obfuscated/thekbd/datasheets/pololu_astar32u4_mini_ulv_pinout.jpg

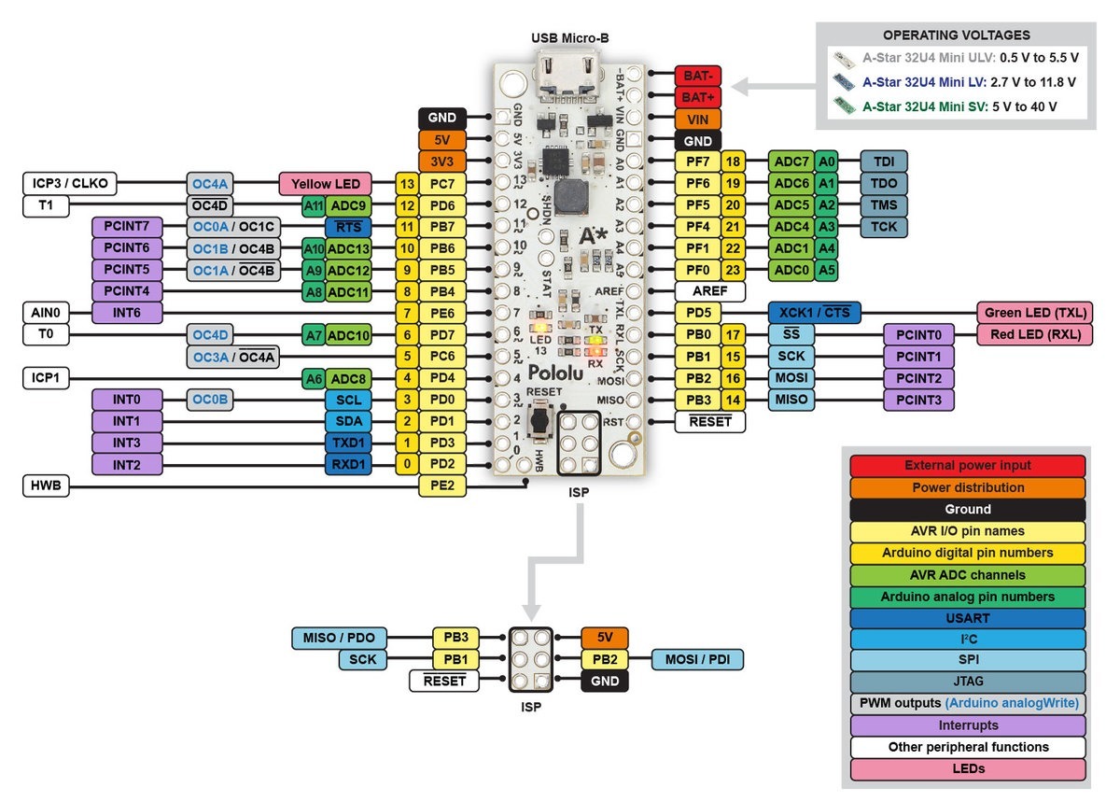
datasheets/pololu_astar32u4_mini_ulv_pinout.jpg
