obfuscated/thekbd/images/mk2.0001.jpg

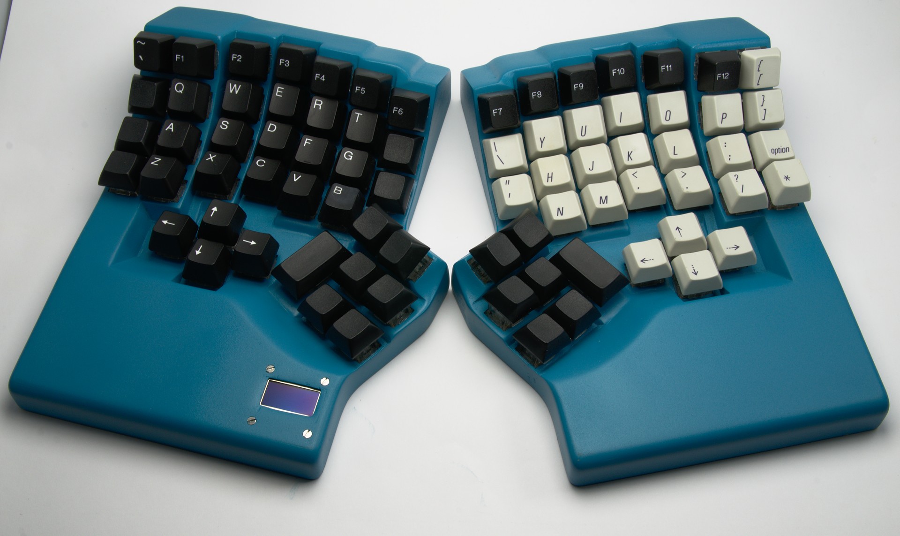
images/mk2.0001.jpg
