obfuscated/thekbd/images/mk2.0003.jpg

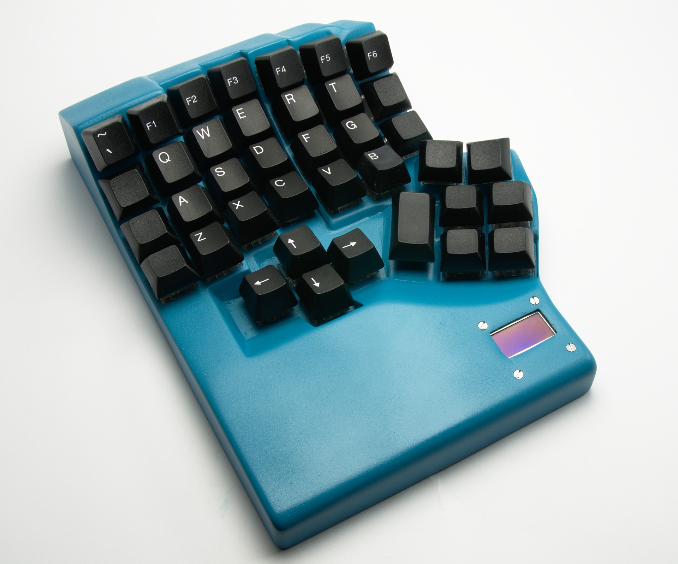
images/mk2.0003.jpg
