obfuscated/thekbd/images/mk2.0004.jpg

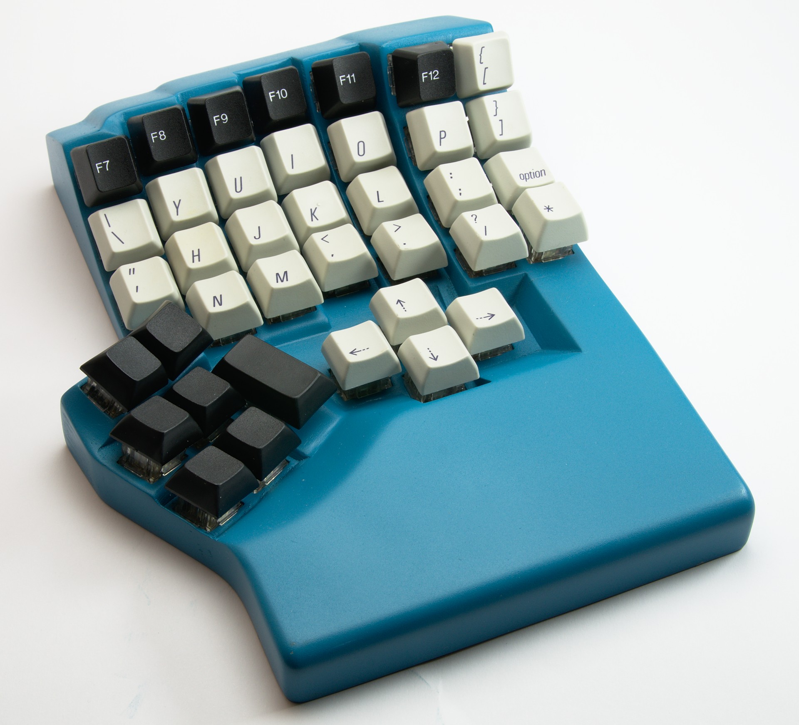
images/mk2.0004.jpg
