obfuscated/thekbd/mapping/mk1-layout.png

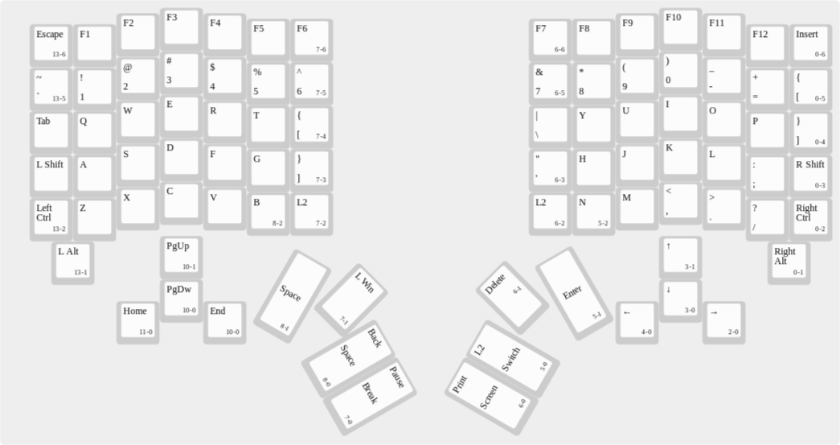
mapping/mk1-layout.png
