obfuscated/thekbd/mapping/mk2-layout.png

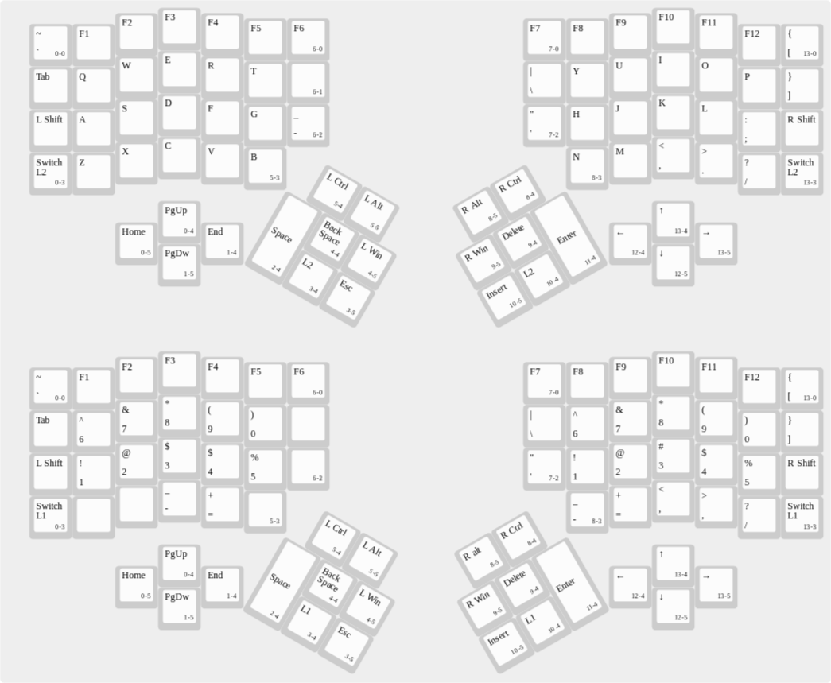
mapping/mk2-layout.png
