obfuscated/thekbd/(commit log)

2014-08-21 Add svg drawings for the case's layers
2014-08-24 Rework the debouncer to use time instead number of iterations
    [firmware.cpp]
2014-08-24 Print the time needed to do 200 iterations
2014-08-26 The fifth row on the right side has been reversed
    [mapping.cpp]
2015-01-04 Switch the I2C frequency to 400khz instead of 800 to see it will stop the crashes
2016-06-18 Mention the Arduino commit that is used to build the firmware
2016-06-18 Reflect the changes in arduino after 1.0.x
    * New folder structure
    * Requires c++11 compiler support
    * The Keyboard class is missing, so this commit leaves the code
    non-compiling.
2016-06-18 Update the git commit info related to the Arduino repo
2016-06-18 Update the Arduino define to 10609
2016-06-18 Disable threadsafe statics - AVRs are single thread/core so no need for this
    * Required to fix undefined symbol linker error
2016-06-18 Better debug - print the row/column of the pressed key in the serial interface
2016-06-18 Try to fix linking issues due to changes in the Arduino code
2016-06-18 Add the path to the HID Arduino files
2016-06-18 Switch to using the KeyboardIO/HID library - full NKRO support is an added bonus
2016-06-18 Fix the delete button
    [mapping.cpp]
2016-06-18 Add curly braces just below the insert key on the right side of the keyboard
2017-01-16 Small optimization
    * Don't switch between input and outputs for the register A. There are
    diodes in the circuit, so there is no way for shorts.
    * This improve the performance from 4.5ms per iteration to 2.7ms per
    iteration.
    [firmware.cpp]
2017-09-03 Swap [ and ] on both sides
    * The position of these keys have been a struggle for me, my brain always
    wanted them to be in reverse. Lets see if I've trained it and the new
    position will be a struggle, too.
    [mapping.cpp]
2017-09-03 Apply some changes to the paths inside the arduino folder
2018-05-29 schematic: Add the KiCad files which shows the mcp23017 side of the schematics
    [schematic.sch]
2018-05-29 schematic: Rename/move files around in preparation for the mk2 files
    [schematic.sch]
2018-05-29 schematic: Add initial mk2 schematic
    [left_side.sch, mk2.sch, right_side.sch]
2018-05-29 schematic: Add more files for the left side
2018-05-29 schematic: Fix the hierarchical schematics and add outputs to left_side
    [left_side.sch, mk2.sch]
2018-05-29 schematic: Add the schematic-cache.lib file
2018-05-29 schematic: Changes made by the latest version of KiCad
    [schematic.sch]
2018-05-29 schematic: Remove schematic-rescue
    [schematic.sch]
2018-05-30 schematic: Add a library with elements from the left side
2018-05-31 schematic: Add the 74hc4050 datasheet
2018-05-31 schematic: Remove all custom libraries except my lib
2018-05-31 schematic: Add the CONN_01x07 to my library
2018-05-31 schematic: Cleanup libs even more (make sure mk2-cache is not used)
    [left_side.sch, mk2.sch, right_side.sch]
2018-05-31 schematic: Remove a backup file
2018-05-31 schematic: Remove the left side cache lib file
2018-05-31 schematic: Remove the left_side.pro and the mk2-cache.lib file
    * Removing the lib makes it possible to open the mk2.sch without errors and
    rescues.
    * The project file for left side doesn't seem useful.
2018-05-31 schematic: Add the i2c port on the right side and connect left and right sides with wires
    [mk2.sch, right_side.sch]
2018-05-31 schematic: Add diode, resistor, push switch and mcp23017 to the library of components
2018-05-31 schematic: Add all needed components to the right side to test if everything is correct
    [right_side.sch]
2018-06-01 schematic: Right side finish the chip part
    [right_side.sch]
2018-06-01 schematic: Add mpc23017 datasheet
2018-06-01 schematic: Add matrix (switches, diodes, wires) to the right side
    [right_side.sch]
2018-06-01 schematic: Move everything in the right side to make it a bit more centered
    [right_side.sch]
2018-06-01 schematic: Move the wires for the rows a bit to the right to make them look visually separated from the wires for the columns
    [right_side.sch]
2018-06-01 schematic: Add connect 1x6 to my library
2018-06-01 schematic: Add switches and diodes to the left side
    [left_side.sch]
2018-06-01 schematic: Remove the bottom row from the right side and center the components a bit
    [right_side.sch]
2018-06-01 firmware: Add some comments why I'm executing the i2c commands
2018-06-01 schematic: Add no connect signs
    [left_side.sch, right_side.sch]
2018-06-01 schematic: KiCad decided to optimise the wires I think
    [right_side.sch]
2018-10-20 schematic: Add pinout for the pololu astar 32u4 mini ulv I'm using
2018-10-20 schematic: Update to KiCad 5
    [left_side.sch, mk2.sch, right_side.sch, schematic.sch]
2018-10-20 schematic: Try to make the schematic look like the real hardware
    * Delete switches which aren't present.
    * Label rows/columns.
    * Add connectors for the right side between the rows/columns and the mcp
    board.
    * Move the matrix down bit in the left side sheet.
    [left_side.sch, right_side.sch]
2018-10-20 schematic: Remove copy pasted left matrix from the right side sheet
    [right_side.sch]
2018-10-20 schematic: Remove accidentally added mk2-cache libraries
    [left_side.sch, mk2.sch, right_side.sch]
2018-12-19 Working version of the mk2 firmware for the left side
    * I originally forgot to commit it.
    * mk2 has the diodes wired in reverse, so the code needs to be in reverse -
    rows are outputs and columns are inputs.
    * The right side is disabled at the moment. It will be enabled after it is
    tested with the hardware.
    [mk2_firmware.cpp]
2018-12-19 schematic: Re-orient all matrix diodes on left/right side
    * This is done to make the schematic match the real hardware. :)
    [left_side.sch, right_side.sch]
2018-12-19 Initial version of the code for drawing on the display (it doesn't work)
    * This based on Adafruit's GFX and SSD1306 libraries, but it can draw fonts
    4 times faster.
    * It is tested on an uno and it seems that it doesn't work on the pololu
    astar mini in the keyboard. :(
    * There is a tool for generating fonts. Comic Neue 16px font is included.
    * This commit introduces a workspace for the firmware and font generator
    projects.
    * I also had to enable SPI for the mk2 target, but keep it disabled for the
    mk1 targets.
    [mk2_firmware.cpp]
2018-12-19 Minimal fixes to the display code - now it works
    * The main problem turned out to be that the RXT pin is used by the USB
    code. There is a led and the USB code wants to flash it, so the user can
    see there is activity on the USB. But this messes up my SPI protocol.
    * To fix the issue I've found an unused pin - 13 and I've modified the
    hardware to use it.
    * The other problem was that the display function has not been called.
    * And there was an of by one error in the line drawing call.
    [mk2_firmware.cpp]
2018-12-19 schematic: Change the SPI pin to d13 from SS
    [left_side.sch]
2018-12-19 schematic: Add no connects to two pins on the 74hc4050
    [left_side.sch]
2018-12-19 Rework the print function to use strings in program memory and to print the scan code
    [mk2_firmware.cpp]
2018-12-19 Workaround compiler problem
    * For some strange reason passing a PROGMEM pointer to a global
    constructor doens't work and changes the pointer. I guess global
    c-tors are bad anyway.
    * This commit introduces an init method which seems to work fine.
    [mk2_firmware.cpp]
2018-12-19 Switch where the binaries from the font generate are stored
2018-12-19 Setup mapping for layer 1 for mk2
    * It is very similar to mk1, but it doesn't have numbers.
    * Added a json file for the online keyboard editor and also a rendered
    image.
    [mapping.cpp]
2018-12-19 Add support for the Switch layer buttons
    * Pressing one of the switch layer buttons switches to the next layer.
    * This is implemented in the MultiLayerPressedState.
    * On switch we release all currently pressed keys. The timing information
    for them doesn't change. Also we reset their state as released.
    * Added a second layer in the layoutTable - it is used to type numbers and
    special characters. Most other keys are the same. The json and png files
    have been updated to match the changes.
    * The active layer is printed on the display.
    [constants.h, mapping.cpp, mk2_firmware.cpp, pressed_state.h]
2018-12-19 Implement the layer select buttons
    * When one of the two layer select buttons is pressed change the active
    layer. When the button is released switch the layer back.
    * At the moment simultaneous press/release of the two buttons won't work
    correctly.
    [pressed_state.h]
2018-12-19 Fix the key repeating when rapidly changing layers
    [pressed_state.h]
2018-12-19 Fix two problems in layer handling
    1. Do not clear the state when the layer changes - doing so means that we
    will send another key press after the layer changes and we don't want
    to do this.
    2. Fix the print statement when selecting a layer with the layer select
    keys.
    [pressed_state.h]
2018-12-19 Draw 'active!' with a font 24px big and bold. Also prevent active from moving when layers change
    [mk2_firmware.cpp]
2018-12-19 schematic: Add datasheets for the pololu a-star and for the OLED display controller
2018-12-19 Add GPL-3 license file
    * Arduino is licensed under LGPL-2.
    * This means that while I use any code from it, the project is effectively
    GPL/LGPL. I do not intend to link arduino's code as a library in order to
    use different kind of license or switch to a closed source license some
    day (highly unlikely).
2019-01-26 Add mapping json/png for mk1, add two new buttons Pause-Break and Print-Screen
2019-01-26 firmware: Try to fix a warning in mk1, unsuccessfully
    [mk1_firmware.cpp]
